WilliamDorey/SPDS/README.md

# SPDS
Files relating to my final project, the Secure Parcel Deposit Station.
